job159/ST7796_STM32F051R8TX/Docs/shot_boot.png

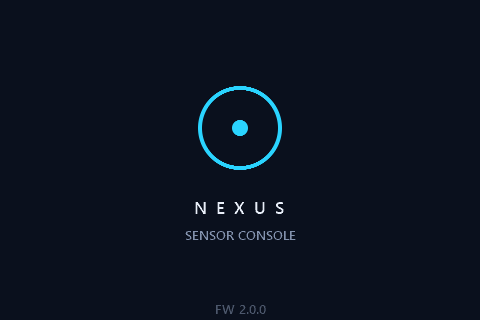
Docs/shot_boot.png
