job159/ST7796_STM32F051R8TX/Docs/shot_cal.png

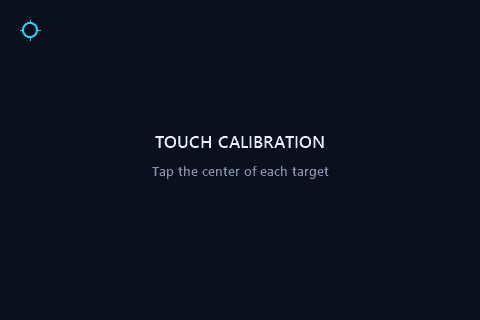
Docs/shot_cal.png
