job159/ST7796_STM32F051R8TX/Docs/shot_dash.png

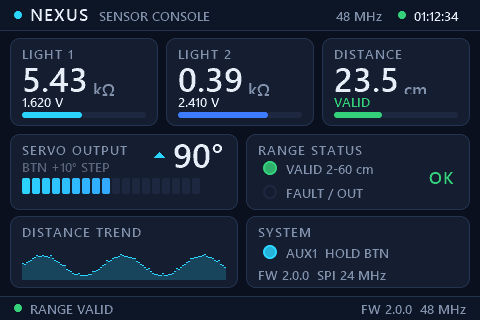
Docs/shot_dash.png
