job159/ST7796_STM32F051R8TX/Docs/shot_fault.png

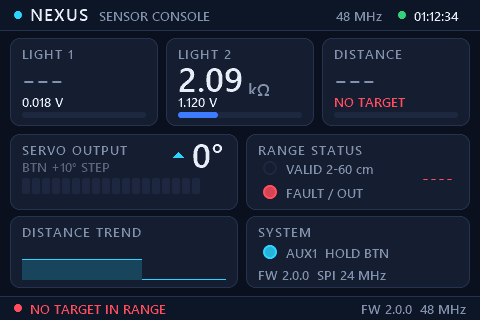
Docs/shot_fault.png
