job159/ST7796_STM32F051R8TX/Docs/shot_loading.png

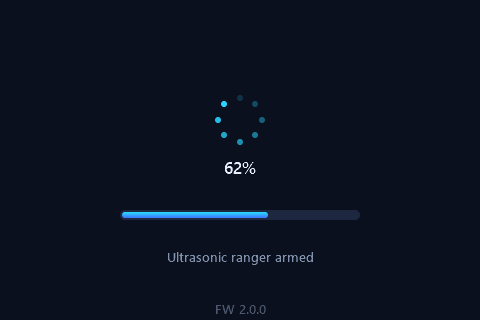
Docs/shot_loading.png
