job159/ST7796_STM32F051R8TX/Core/Src/main.c

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
/* Includes ------------------------------------------------------------------*/
#include "main.h"

/* USER CODE BEGIN Includes */
#include "board.h"
#include "ili9488.h"
#include "xpt2046.h"
#include "sensors.h"
#include "ui.h"
/* USER CODE END Includes */


void SystemClock_Config(void);
/**
  * @brief  The application entry point.
  * @retval int
  */
int main(void)
{
  /* MCU Configuration--------------------------------------------------------*/

  /* Reset of all peripherals, Initializes the Flash interface and the Systick. */
  HAL_Init();

  /* Configure the system clock */
  SystemClock_Config();

  /* USER CODE BEGIN SysInit */
  board_clock48();          /* HSI/2 x PLL12 -> 48 MHz, 1 WS            */
  /* USER CODE END SysInit */

  /* Initialize all configured peripherals */
  /* USER CODE BEGIN 2 */
  board_init();             /* GPIO, LEDs, button, backlight PWM, us tim */

  /* bring-up heartbeat, runs before any display access:
   * PC8 + PC9 blink twice and the PB9 backlight flashes with them.
   * No blink at all = firmware is not running (flash/board issue).     */
  for (int i = 0; i < 3; i++) {
    board_led(0, true);  board_led(1, true);  board_backlight(100);
    HAL_Delay(120);
    board_led(0, false); board_led(1, false); board_backlight(0);
    HAL_Delay(120);
  }

  lcd_init();               /* ST7796/ILI9488 via SPI1                   */
  touch_init();             /* XPT2046 via SPI2, cal from flash          */
  sensors_init();           /* 2x LDR on ADC1, HC-SR04 on PA8/PA9        */
  motor_init();             /* TIM3 CH1 PWM on PB4                       */
  motor_set(90);
  ui_init();                /* boot + loading animation, dashboard       */
  /* USER CODE END 2 */

  /* Infinite loop */
  /* USER CODE BEGIN WHILE */
  while (1)
  {
    ui_task();
    /* USER CODE END WHILE */

    /* USER CODE BEGIN 3 */
  }
  /* USER CODE END 3 */
}

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
